dfurline01/solar-simulator/docs/Solidworks Assembly.png

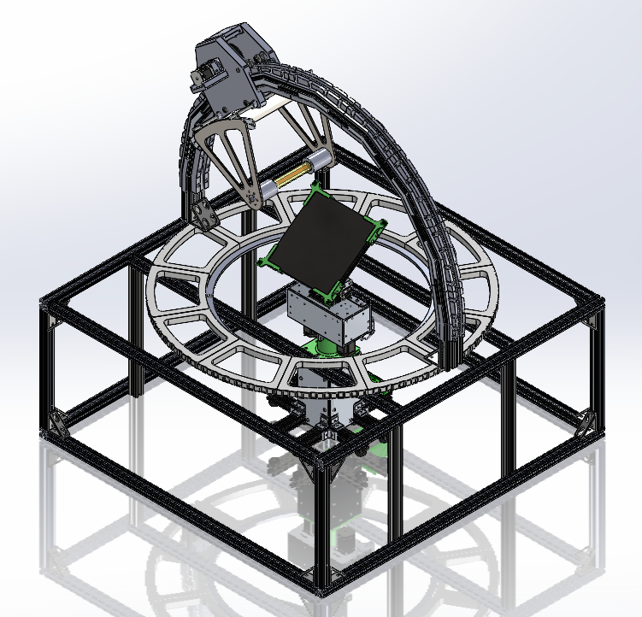
docs/Solidworks Assembly.png
