dfurline01/solar-simulator/README.md

# solar-simulator
Open-source indoor solar simulator with compressed-daylight playback and integrated heliostat tracking
