dfurline01/solar-simulator/docs/MechE Capstone Poster.pdf

# Indoor Solar Simulator

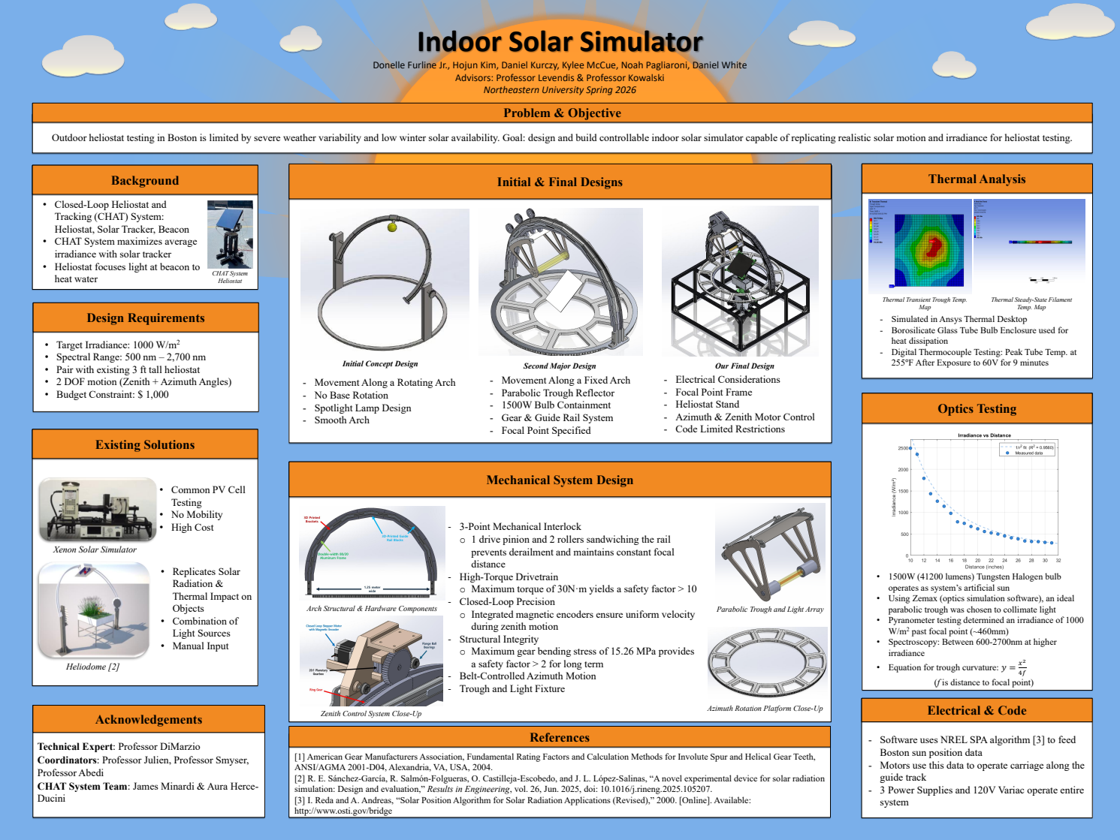
[picture p29: page 1]
Background; Problem & Objective; References; Design Requirements; Existing Solutions; Heliodome [2]; Optics Testing; Acknowledgements; Map; Initial Concept Design; Second Major Design; Our Final Design; Temp. Map; Electrical & Code; CHAT System Heliostat

Donelle Furline Jr., Hojun Kim, Daniel Kurczy, Kylee McCue, Noah Pagliaroni, Daniel White

Advisors: Professor Levendis & Professor Kowalski
Northeastern University Spring 2026

Outdoor heliostat testing in Boston is limited by severe weather variability and low winter solar availability. Goal: design and build controllable indoor solar simulator capable of replicating realistic solar motion and irradiance for heliostat testing.

Thermal Analysis Initial & Final Designs

• Closed-Loop Heliostat and
Tracking (CHAT) System:
Heliostat, Solar Tracker, Beacon
• CHAT System maximizes average
irradiance with solar tracker
• Heliostat focuses light at beacon to
heat water

Thermal Transient Trough Temp.

Thermal Steady-State Filament

- Simulated in Ansys Thermal Desktop
- Borosilicate Glass Tube Bulb Enclosure used for
heat dissipation
- Digital Thermocouple Testing: Peak Tube Temp. at
255°F After Exposure to 60V for 9 minutes

• Target Irradiance: 1000 W/m²
• Spectral Range: 500 nm – 2,700 nm
• Pair with existing 3 ft tall heliostat
• 2 DOF motion (Zenith + Azimuth Angles)
• Budget Constraint: $ 1,000

- Movement Along a Fixed Arch
- Parabolic Trough Reflector
- 1500W Bulb Containment
- Gear & Guide Rail System
- Focal Point Specified

- Electrical Considerations
- Focal Point Frame
- Heliostat Stand
- Azimuth & Zenith Motor Control
- Code Limited Restrictions

- Movement Along a Rotating Arch
- No Base Rotation
- Spotlight Lamp Design
- Smooth Arch

Mechanical System Design

• Common PV Cell
Testing
• No Mobility
• High Cost

- 3-Point Mechanical Interlock
• 1 drive pinion and 2 rollers sandwiching the rail
prevents derailment and maintains constant focal
distance
- High-Torque Drivetrain
• Maximum torque of 30N·m yields a safety factor > 10
- Closed-Loop Precision
• Integrated magnetic encoders ensure uniform velocity
during zenith motion
- Structural Integrity
• Maximum gear bending stress of 15.26 MPa provides
a safety factor > 2 for long term
- Belt-Controlled Azimuth Motion
- Trough and Light Fixture

Xenon Solar Simulator

• Replicates Solar
Radiation &
Thermal Impact on
Objects
• Combination of
Light Sources
• Manual Input

• 1500W (41200 lumens) Tungsten Halogen bulb
operates as system’s artificial sun
• Using Zemax (optics simulation software), an ideal
parabolic trough was chosen to collimate light
• Pyranometer testing determined an irradiance of 1000
W/m² past focal point (~460mm)
• Spectroscopy: Between 600-2700nm at higher
irradiance
• Equation for trough curvature: y =

Arch Structural & Hardware Components

Parabolic Trough and Light Array

(f is distance to focal point)

Azimuth Rotation Platform Close-Up

Zenith Control System Close-Up

- Software uses NREL SPA algorithm [3] to feed
Boston sun position data
- Motors use this data to operate carriage along the
guide track
- 3 Power Supplies and 120V Variac operate entire
system

Technical Expert: Professor DiMarzio
Coordinators: Professor Julien, Professor Smyser,
Professor Abedi
CHAT System Team: James Minardi & Aura Herce-
Ducini

[1] American Gear Manufacturers Association, Fundamental Rating Factors and Calculation Methods for Involute Spur and Helical Gear Teeth,
ANSI/AGMA 2001-D04, Alexandria, VA, USA, 2004.
[2] R. E. Sánchez-García, R. Salmón-Folgueras, O. Castilleja-Escobedo, and J. L. López-Salinas, “A novel experimental device for solar radiation
simulation: Design and evaluation,” Results in Engineering, vol. 26, Jun. 2025, doi: 10.1016/j.rineng.2025.105207.
[3] I. Reda and A. Andreas, “Solar Position Algorithm for Solar Radiation Applications (Revised),” 2000. [Online]. Available:
http://www.osti.gov/bridge
